IowaScaledEngineering/snd-defect/(commit log)

2024-05-11 Initial checkin
    [partitions.csv]
2024-05-13 Generalized vocab search. Fixed noise filtering.
    [snd-defect.ino]
2025-04-07 Initial HW design
    [snd-defect.kicad_pcb, snd-defect.kicad_sch]
2025-04-07 Additional schematic updates
    [snd-defect.kicad_sch]
2025-05-08 Updated footprints, added power jack, modified switches, added temp sensor
    [snd-defect.kicad_sch]
2025-05-10 Initial (partial) placement
    [snd-defect.kicad_pcb, snd-defect.kicad_sch]
2025-05-18 Added note
    [snd-defect.kicad_sch]
2025-05-19 Removed display and buttons + initial placement
    [snd-defect.kicad_pcb, snd-defect.kicad_sch]
2025-05-19 Started routing
    [snd-defect.kicad_pcb, snd-defect.kicad_sch]
2025-05-19 Fixed 3D model paths
    [snd-defect.kicad_pcb]
2025-05-20 Finished wiring
    [snd-defect.kicad_pcb, snd-defect.kicad_sch]
2025-05-20 Updated 3D models
    [snd-defect.kicad_pcb]
2025-05-20 Fixed 3D model alignment
    [snd-defect.kicad_pcb]
2025-05-20 Added additional 3.3V via
    [snd-defect.kicad_pcb]
2025-05-20 Fixed some planes around the switching regulator
    [snd-defect.kicad_pcb]
2025-05-20 Nits picked
    [snd-defect.kicad_pcb, snd-defect.kicad_sch]
2025-05-21 Added status LED
    [snd-defect.kicad_pcb, snd-defect.kicad_sch]
2025-05-31 Layout cleanup
    [snd-defect.kicad_pcb]
2025-06-01 Minor tweaks
    [snd-defect.kicad_pcb]
