IowaScaledEngineering/snd-defect/(notices)

Notices in the files:
kicad/snd-defect/snd-defect.kicad_pcb:
©2025 CC BY-SA
parts and their libraries:
Copyright 2021 Accelerated Designs. All rights reserved.
